tdarlic/EMC_5uH_LISN/BOM/5uH_LISN_BOM.csv

Designator | Value | Footprint | Qty | Manufacturer | MPN | Mouser No | LCSC No | Description | DNP
C1,C2 | 22uF | Capacitor_SMD:C_2220_5650Metric | 2 | TDK | CKG57NX7S2A226MT0Y9W |  | C694539 | CAP CER 22uF 100V X7S 20% 2220 stacked (MEGACAP)
C5,C6,C7,C8 | 2.2uF | Capacitor_SMD:C_1210_3225Metric | 4 | TDK | CGA6N3X7R2A225KT0Y0U |  | C342652 | CAP CER 2.2uF 100V X7R 10% 1210 AEC-Q200
C11,C12,C13,C14 | 470nF | Capacitor_SMD:C_0805_2012Metric | 4 | KYOCERA AVX | 08051C474KAT2A | 581-08051C474KAT2A | C597304 | CAP CER 0.47uF 100V X7R 10% 0805
C15,C16 | 100nF | Capacitor_SMD:C_1206_3216Metric | 2 | Murata | GRM31CR72E104KW03L |  | C97956 | CAP CER 0.1uF 250V X7R 10% 1206
CASE_HAMMOND_1590BBK1 |  |  | 1 | Hammond Manufacturing | 1590BBK | 546-1590B-BK |  | Diecast aluminium enclosure, black, 111.99 x 60.5 x 31 mm
D1,D2,D3,D4 | SOT23-DIODEDUAL | 5uH_LISN:SOT23-DIODEDUAL | 4 | Nexperia | BAV99,215 |  | C2500 | Dual series switching diode 100V 215mA SOT-23
GD1,GD2 | S30-A75X | 5uH_LISN:S30-A400X | 2 | TDK | B88069X1023T253 | 871-B88069X1023T253 | C3660736 | GDT S30-A75X 75V 5kA 2-pole SMD 1812
H1,H2,H3,H4 | MOUNT-PAD-ROUND4.1 | 5uH_LISN:4,1-PAD | 4
J1,J2 | Conn_SMA | Connector_Coaxial:SMA_Wurth_60312002114503_Vertical | 2 | Wurth Elektronik | 60312002114503 | 710-60312002114503 | C6823889 | WR-SMA PCB THT jack straight 50 Ohm
J3,J4,J5,J6,J7,J8 | BANANA_CONN | 5uH_LISN:BANANA_CONN | 6 | Keystone Electronics | 575-8 | 534-575-8 | C4994335 | Banana jack, solder/staking mount, non-insulated, 0.350in
L1,L2,L3,L4,L5,L7,L8,L9,L10,L11 | 1.1uH | 5uH_LISN:WE-HCI_7030_7040_7050 | 10 | Wurth Elektronik | 744314110 | 710-744314110 |  | WE-HCI power inductor 1.1uH 15A DCR 3.15mOhm AEC-Q200
L6,L12 | 1mH | 5uH_LISN:COILCRAFT_1008PS | 2 | MYX | MWI1008PS102MST-HF |  | C48946652 | Shielded inductor 1mH 20% 110mA 29 Ohm 1008 (alt. Coilcraft 1008PS-105KLC)
R1,R2 | 909R | Resistor_SMD:R_0805_2012Metric | 2 | RESI | PTFR0805B909RP9 |  | C2849379 | RES 909 Ohm 0.1% 130mW 0805 thin film
R3,R4 | 1R | Resistor_SMD:R_1218_3246Metric | 2 | Vishay | RCL12181R00FKEK |  | C2075765 | RES 1 Ohm 1% 1W 1218 wide terminal (alt. LCSC C175575 0.5W 5%)
R5,R6 | 825R | Resistor_SMD:R_0805_2012Metric | 2 | KOA Speer | RK73H2ATTD8250F |  | C6182695 | RES 825 Ohm 1% 250mW 0805 thick film
R7,R8 | 12.1R | Resistor_SMD:R_1206_3216Metric | 2 | YAGEO | RT1206BRD0712R1L |  | C870402 | RES 12.1 Ohm 0.1% 250mW 1206 thin film
R9,R10,R13,R14 | 0R | Resistor_SMD:R_1206_3216Metric | 4 | UNI-ROYAL | 1206W4F0000T5E |  | C17888 | RES 0 Ohm jumper 1206
R11,R12 | 243R | Resistor_SMD:R_0805_2012Metric | 2 | YAGEO | RT0805BRD07243RL |  | C865323 | RES 243 Ohm 0.1% 125mW 0805 thin film - NOTE: ~0.17W at 1W input
R15,R16 | 274R | Resistor_SMD:R_0805_2012Metric | 2 | YAGEO | RT0805BRD07274RL |  | C865345 | RES 274 Ohm 0.1% 125mW 0805 thin film - NOTE: ~0.15W at 1W input
R17,R18 | 30.1R | Resistor_SMD:R_1206_3216Metric | 2 | UNI-ROYAL | HP06W2F301JT5E |  | C2774910 | RES 30.1 Ohm 1% 500mW 1206 thick film
R19,R20,R21,R22,R23,R24,R25,R26 | 432R | Resistor_SMD:R_0805_2012Metric | 8 | YAGEO | RT0805BRD07432RL | 603-RT0805BRD07432RL | C865490 | RES 432 Ohm 0.1% 125mW 0805 thin film
R27,R28 | 18.2R | Resistor_SMD:R_1206_3216Metric | 2 | FOJAN | FRC1206F18R2TS |  | C5126139 | RES 18.2 Ohm 1% 250mW 1206 thick film
R29,R30 | 562R | Resistor_SMD:R_0805_2012Metric | 2 | Viking Tech | ARG05FTC5620 |  | C218625 | RES 562 Ohm 1% 125mW 0805 thin film
R31,R32 | 619R | Resistor_SMD:R_0805_2012Metric | 2 | YAGEO | RC0805FR-07619RL |  | C273913 | RES 619 Ohm 1% 125mW 0805 thick film
