tdarlic/EMC_5uH_LISN/BOM/5uH_LISN_BOM_draft_manual.csv

Item | Reference | Qty/board | Order qty | Value | Package | Manufacturer | Mfr. No | Mouser No | Mouser No status | LCSC No | Description | Notes
1 | CASE_HAMMOND_1590BBK1 | 1 | 1 | 1590BBK | Diecast box | Hammond | 1590BBK | 546-1590B-BK | chosen by user |  | Diecast aluminium enclosure black 111.99x60.5x31 mm
2 | L1-L5,L7-L11 | 10 | 10 | 1.1uH | WE-HCI 7030 | Wurth Elektronik | 744314110 | 710-744314110 | chosen by user |  | WE-HCI 1.1uH 15A DCR 3.15mOhm AEC-Q200 | 5 in series per line = ~5.5uH
3 | C1,C2 | 2 | 2 | 22uF 100V X7S | 2220 | TDK | CKG57NX7S2A226M500JH | CKG57NX7S2A226M500JH | verify |  | CAP CER 22uF 100V X7S stacked (MEGACAP) | Order by MPN
4 | C5-C8 | 4 | 5 | 2.2uF 100V X7R | 1210 | TDK | CGA6N3X7R2A225K230AB | CGA6N3X7R2A225K230AB | verify |  | CAP CER 2.2uF 100V X7R 10% | Any 2.2uF 100V X7R 1210 (e.g. Murata GRM32ER72A225K) is fine
5 | C11-C14 | 4 | 10 | 470nF 100V X7R | 805 | KYOCERA AVX | 08051C474KAT2A | 581-08051C474KAT2A | expected |  | CAP CER 0.47uF 100V X7R 10%
6 | C15,C16 | 2 | 10 | 100nF 250V X7R | 1206 | TDK | C3216X7R2E104K160AA | C3216X7R2E104K160AA | verify |  | CAP CER 0.1uF 250V X7R 10%
7 | D1-D4 | 4 | 10 | BAV99 | SOT-23 | Nexperia | BAV99,215 | 771-BAV99-T/R | expected | C2500 | Dual series switching diode 100V 215mA
8 | GD1,GD2 | 2 | 2 | S30-A75X | 1812 SMD | TDK (EPCOS) | B88069X1023T253 | 871-B88069X1023T253 | expected |  | GDT 75V 2-pole SMD (S30 series) | Footprint is named S30-A400X but same S30 package
9 | J1,J2 | 2 | 2 | SMA jack | THT vertical | Wurth Elektronik | 60312002114503 | 710-60312002114503 | expected |  | WR-SMA PCB THT jack straight | Schematic MPN is TE 5-1814832-2 | Wurth part matches the PCB footprint
10 | J3-J8 | 6 | 6 | Banana jack | THT | Keystone | 575-8 | 534-575-8 | expected |  | Banana jack solder mount non-insulated 0.350in | Schematic still says 575-4 | README says 575-8 (575-4 too short)
11 | L6,L12 | 2 | 2 | 1mH | 1008 | Coilcraft | 1008PS-105KLC | 994-1008PS-105KLC | expected |  | Shielded inductor 1mH 10% 100mA 29 Ohm
12 | R1,R2 | 2 | 10 | 909R 0.1% | 805 | TE Connectivity | RQ73C2A909RBTD | 279-RQ73C2A909RBTD | expected |  | Thin film 0.1% 1/5W anti-sulfur
13 | R3,R4 | 2 | 5 | 1R 1% 1W | 1218 wide terminal | KOA Speer | WK73S2JTTE1R00F | 660-WK73S2JTTE1R00F | expected |  | Thick film 1W wide terminal
14 | R5,R6 | 2 | 10 | 825R 0.1% | 805 | Panasonic | ERJ-PB6B8250V | 667-ERJ-PB6B8250V | expected |  | Pulse withstanding thick film 0.1% 1/4W
15 | R7,R8 | 2 | 10 | 12.1R 0.1% | 1206 | TE Connectivity | RQ73C2B12R1BTD | 279-RQ73C2B12R1BTD | expected |  | Thin film 0.1% 0.4W anti-sulfur
16 | R9,R10,R13,R14 | 4 | 10 | 0R | 1206 | YAGEO | RC1206JR-7W0RL | 603-RC1206JR-7W0RL | expected |  | Jumper 0R 1/2W
17 | R11,R12 | 2 | 10 | 243R 0.1% | 805 | TE Connectivity | RQ73C2A243RBTD | 279-RQ73C2A243RBTD | expected |  | Thin film 0.1% 1/5W anti-sulfur
18 | R15,R16 | 2 | 10 | 274R 0.1% | 805 | TE Connectivity | 6-2176091-5 | 6-2176091-5 | verify |  | Thin film 0.1% 1/4W
19 | R17,R18 | 2 | 10 | 30.1R 0.1% | 1206 | TE Connectivity | RQ73C2B30R1BTD | 279-RQ73C2B30R1BTD | expected |  | Thin film 0.1% 0.4W anti-sulfur
20 | R19-R26 | 8 | 10 | 432R 0.1% | 805 | TE Connectivity | 8-2176091-3 | 8-2176091-3 | verify |  | Thin film 0.1% 1/4W
21 | R27,R28 | 2 | 10 | 18.2R 0.1% | 1206 | TE Connectivity | RQ73C2B18R2BTD | 279-RQ73C2B18R2BTD | expected |  | Thin film 0.1% 0.4W anti-sulfur
22 | R29,R30 | 2 | 10 | 562R 0.1% | 805 | TE Connectivity | 9-2176091-4 | 9-2176091-4 | verify |  | Thin film 0.1% 1/4W
23 | R31,R32 | 2 | 10 | 619R 0.1% | 805 | TE Connectivity | RQ73C2A619RBTD | 279-RQ73C2A619RBTD | expected |  | Thin film 0.1% 1/5W anti-sulfur
24 | H1-H4 | 4 | 0 | Mounting pad | 4.1 mm hole |  |  |  |  |  | PCB mounting holes (no part) | Screws/standoffs optional - not in schematic
