tdarlic/EMC_5uH_LISN/(commit log)

2026-11-02 Add BOM to the project
    BOM is combination of Mouser/LCSC
    [5uH_LISN-B_Mask.gbs, 5uH_LISN-B_Paste.gbp, 5uH_LISN-B_Silkscreen.gbo, 5uH_LISN-Back.gbl, 5uH_LISN-Edge_Cuts.gm1, 5uH_LISN-F_Mask.gts, 5uH_LISN-F_Paste.gtp, 5uH_LISN-F_Silkscreen.gto]
2026-11-02 Add JLCPCB order
    [5uH_LISN.kicad_sch, 5uH_LISN_BOM.csv, hand_bom.csv, jlc_bom.csv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]
